KarpelesLab/lightning_debug/tools/parts.csv

# Part numbers merged into the BOM by tools/export_fab.py (key = value + footprint).
# lcsc = JLCPCB/LCSC part (all checked against the JLCPCB parts library on 2026-11-09:
# exact MPN match | in stock); manufacturer/mpn for PCBWay. Resistors/caps/ferrite/crystal
# are JLCPCB basic parts where one exists; the rest are extended parts (setup fee each).
value | footprint | lcsc | manufacturer | mpn | refs
USER | Button_Switch_SMD:SW_SPST_PTS810 | C116501 | C&K | PTS810SJM250SMTRLFS | SW1
100n | Capacitor_SMD:C_0603_1608Metric | C14663 | YAGEO | CC0603KRX7R9BB104 | C2 C10 C11 C12 C14 C15 C16 C17 C18 C19 C23 C25 C26 C28 C29 C30 C31 C32 C33 C35 C36
1u | Capacitor_SMD:C_0603_1608Metric | C15849 | Samsung | CL10A105KB8NNNC | C3 C5 C27
27p | Capacitor_SMD:C_0603_1608Metric | C1656 | Samsung | CL10C270JB8NNNC | C20 C21
10u | Capacitor_SMD:C_0805_2012Metric | C15850 | Samsung | CL21A106KAYNNNE | C1 C4 C6 C7 C22 C24 C37 C38
4.7u | Capacitor_SMD:C_0805_2012Metric | C1779 | Samsung | CL21A475KAQNNNE | C8 C9 C13 C34
USB_C_Receptacle_USB2.0_16P | Connector_USB:USB_C_Receptacle_HRO_TYPE-C-31-M-12 | C165948 | Korean Hroparts | TYPE-C-31-M-12 | J1 J2
12MHz | Crystal:Crystal_SMD_3225-4Pin_3.2x2.5mm | C9002 | Yangxing | X322512MSB4SI | Y1
1.5A hold | Fuse:Fuse_1206_3216Metric | C20802 | Sunlord | SMD1206P150TF | F1
600R@100MHz | Inductor_SMD:L_0603_1608Metric | C1002 | Sunlord | GZ1608D601TF | FB1
blue | LED_SMD:LED_0603_1608Metric | C2288 | Hubei KENTO | KT-0603B | D5
green | LED_SMD:LED_0603_1608Metric | C12624 | Hubei KENTO | KT-0603G | D4
green PWR | LED_SMD:LED_0603_1608Metric | C12624 | Hubei KENTO | KT-0603G | D1
red | LED_SMD:LED_0603_1608Metric | C2286 | Hubei KENTO | KT-0603R | D3
yellow LTG PWR | LED_SMD:LED_0603_1608Metric | C2287 | Hubei KENTO | KT-0603Y | D2
ASE-12.000MHz | Oscillator:Oscillator_SMD_Abracon_ASE-4Pin_3.2x2.5mm | C596950 | Abracon | ASE-12.000MHZ-LC-T | X1
ICE40UP5K-SG48ITR | Package_DFN_QFN:QFN-48-1EP_7x7mm_P0.5mm_EP5.6x5.6mm | C2678152 | Lattice | ICE40UP5K-SG48I | U7
FT2232HQ | Package_DFN_QFN:QFN-64-1EP_9x9mm_P0.5mm_EP4.35x4.35mm | C193662 | FTDI | FT2232HQ-REEL | U5
FSUSB42MUX | Package_SO:MSOP-10_3x3mm_P0.5mm | C11355 | onsemi | FSUSB42MUX | U10 U11
93LC56B | Package_SO:SOIC-8_3.9x4.9mm_P1.27mm | C6164 | Microchip | 93LC56BT-I/SN | U6
W25Q128JVS | Package_SO:SOIC-8_5.3x5.3mm_P1.27mm | C97521 | Winbond | W25Q128JVSIQ | U8
AP2112K-1.2 | Package_TO_SOT_SMD:SOT-23-5 | C460310 | Diodes Inc | AP2112K-1.2TRG1 | U3
AP2112K-1.8 | Package_TO_SOT_SMD:SOT-23-5 | C176944 | Diodes Inc | AP2112K-1.8TRG1 | U4
AP2112K-3.3 | Package_TO_SOT_SMD:SOT-23-5 | C51118 | Diodes Inc | AP2112K-3.3TRG1 | U2
TPS2065CDBV | Package_TO_SOT_SMD:SOT-23-5 | C353882 | Texas Instruments | TPS2065CDBVR | U12
USBLC6-2SC6 | Package_TO_SOT_SMD:SOT-23-6 | C7519 | STMicroelectronics | USBLC6-2SC6 | U1 U9
100 | Resistor_SMD:R_0603_1608Metric | C22775 | UNI-ROYAL | 0603WAF1000T5E | R10
100k | Resistor_SMD:R_0603_1608Metric | C25803 | UNI-ROYAL | 0603WAF1003T5E | R41
10k | Resistor_SMD:R_0603_1608Metric | C25804 | UNI-ROYAL | 0603WAF1002T5E | R5 R6 R7 R8 R11 R12 R13 R14 R15 R29 R30 R31 R32 R35 R37 R38 R39 R40 R42 R44
12k 1% | Resistor_SMD:R_0603_1608Metric | C22790 | UNI-ROYAL | 0603WAF1202T5E | R4
1k | Resistor_SMD:R_0603_1608Metric | C21190 | UNI-ROYAL | 0603WAF1001T5E | R3
2.2k | Resistor_SMD:R_0603_1608Metric | C4190 | UNI-ROYAL | 0603WAF2201T5E | R9 R43
33 | Resistor_SMD:R_0603_1608Metric | C23140 | UNI-ROYAL | 0603WAF330JT5E | R16 R17 R18 R19 R20 R21 R22 R23 R24 R25 R26 R27 R28
4.7k | Resistor_SMD:R_0603_1608Metric | C23162 | UNI-ROYAL | 0603WAF4701T5E | R36
5.1k | Resistor_SMD:R_0603_1608Metric | C23186 | UNI-ROYAL | 0603WAF5101T5E | R1 R2 R33 R34
