KarpelesLab/lightning_debug/docs/APPLE-LM-BO-V1AV Drawing Rev1.0.pdf

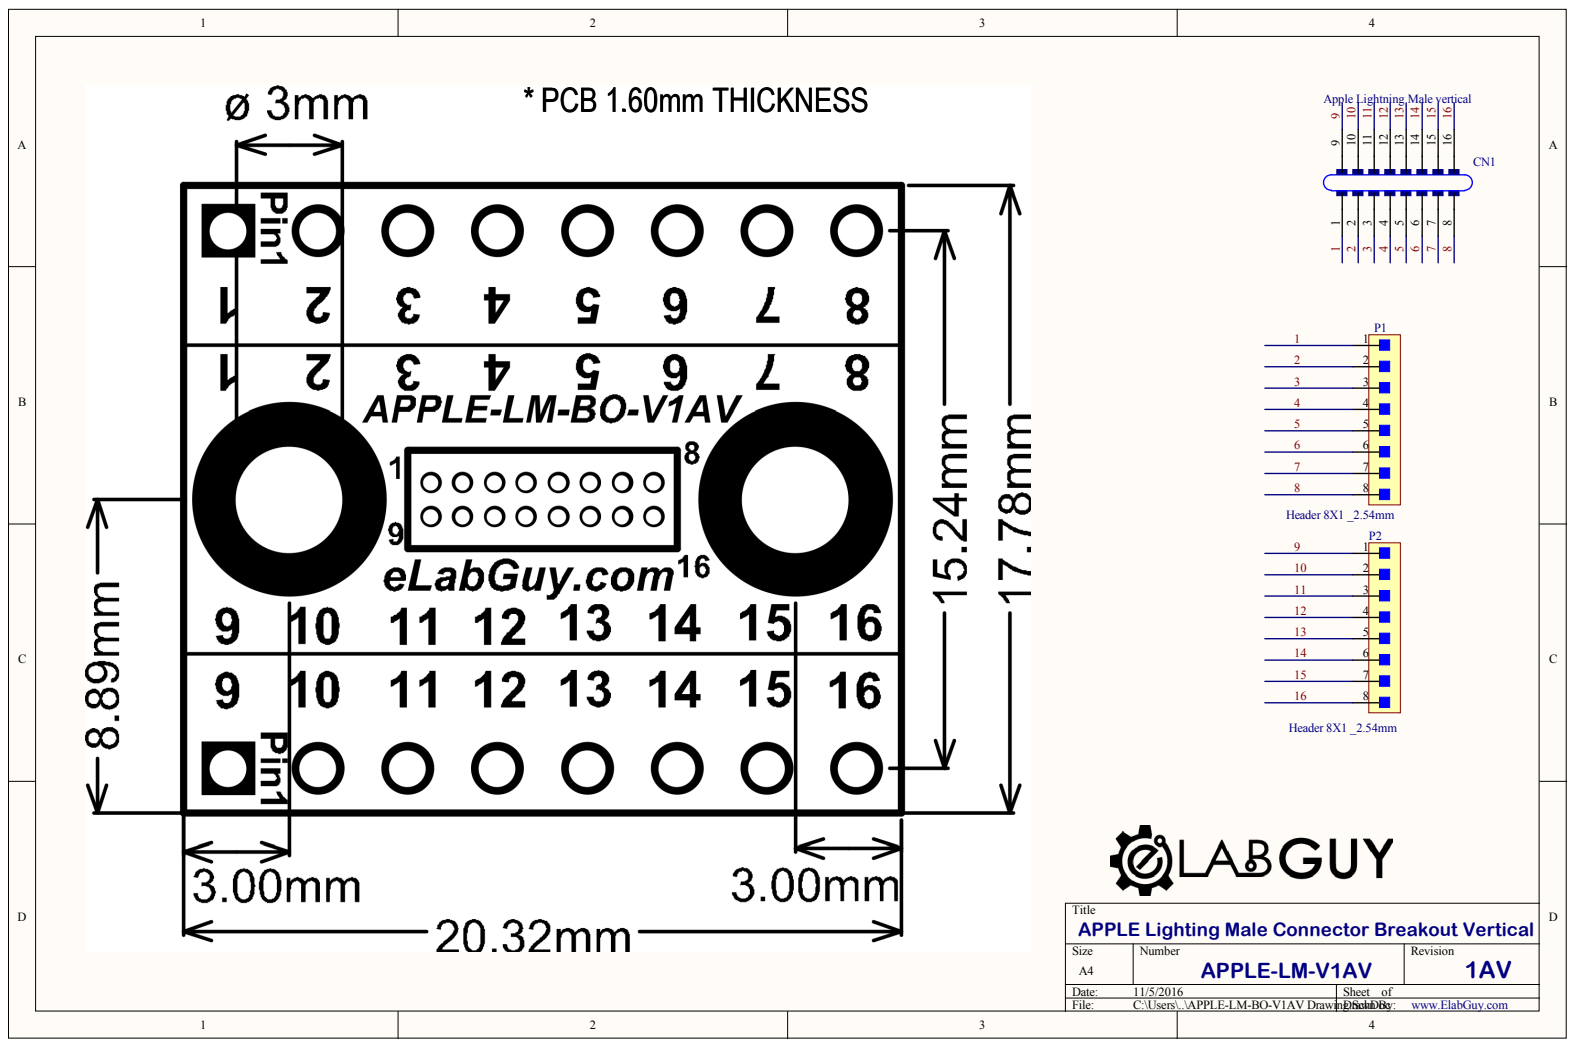
[picture p4: page 1]

Apple Lightning Male vertical

Title
APPLE Lighting Male Connector Breakout Vertical

Size A4 | Number APPLE-LM-V1AV | Revision 1AV

Date: 11/5/2016 | Sheet of
File: C:\Users\..\APPLE-LM-BO-V1AV Drawing. DrSacwhDn Bocy: | www.ElabGuy.com
