KarpelesLab/lightning_debug/docs/APPLE-LM-BO-V2A Drawing Rev1.0.pdf

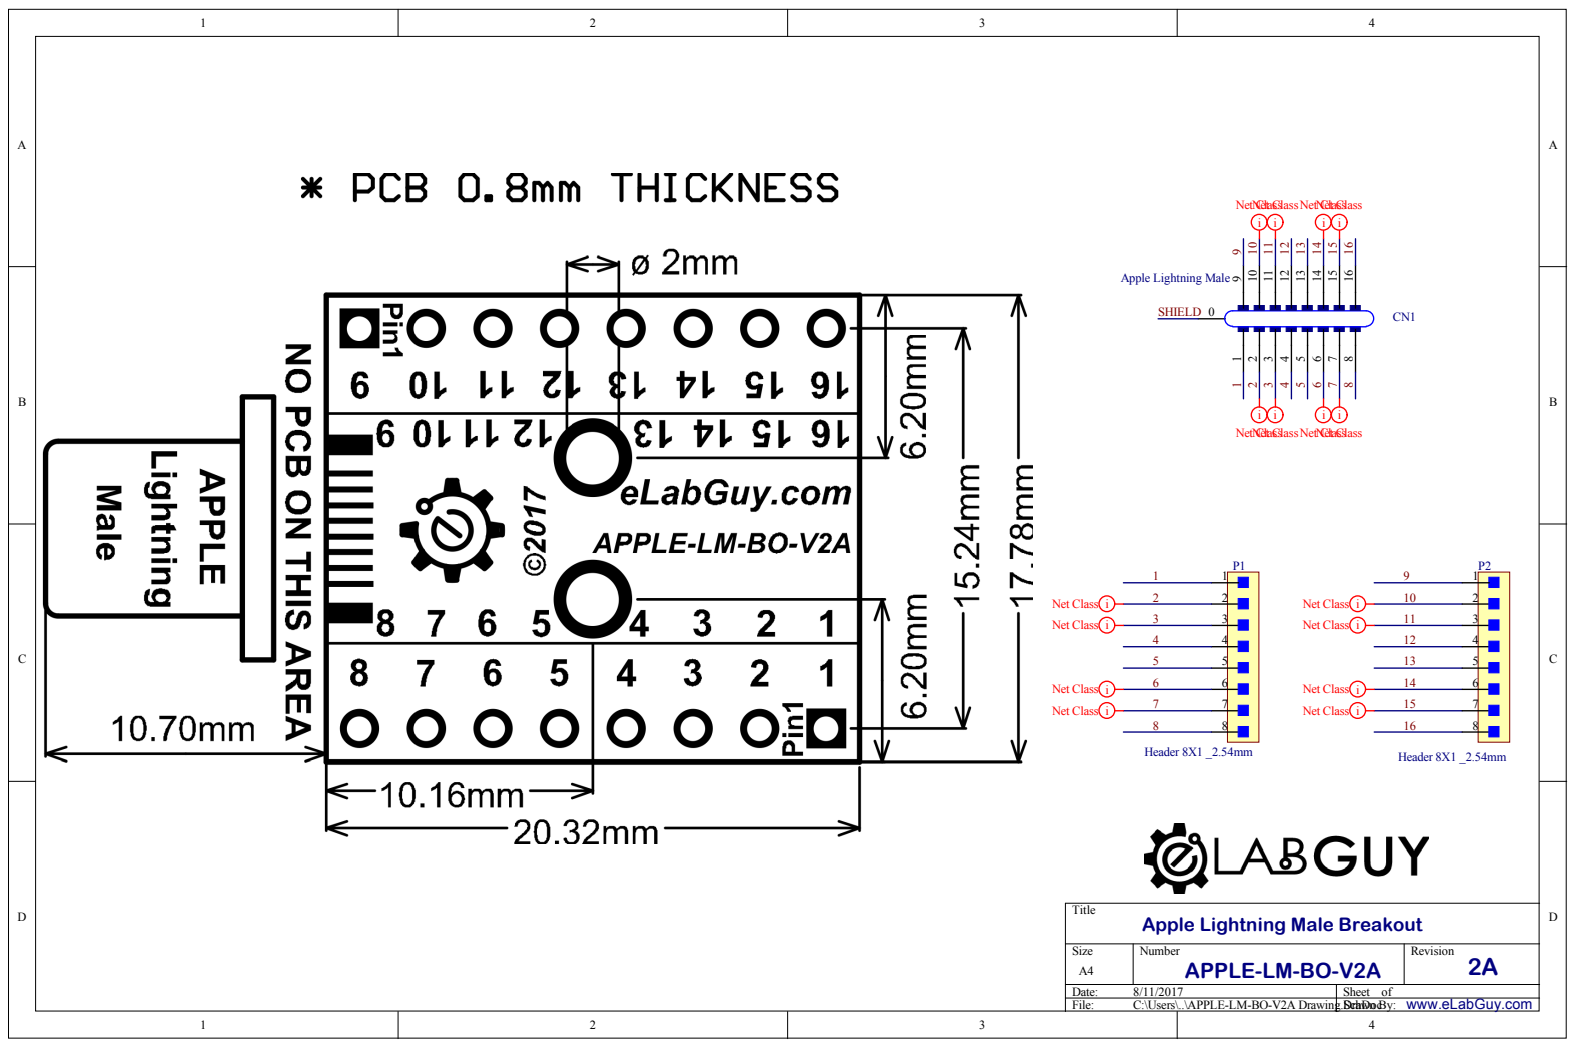
[picture p5: page 1]

Apple Lightning Male Breakout

Size A4 | Number APPLE-LM-BO-V2A | Revision 2A

Date: 8/11/2017 | Sheet of
File: C:\Users\..\APPLE-LM-BO-V2A Drawing.DScrhDawn ocBy: | www.eLabGuy.com
