KarpelesLab/lightning_debug/lightning_debug.kicad_pcb

## KiCad design lightning_debug.kicad_pcb (2026-11-09)

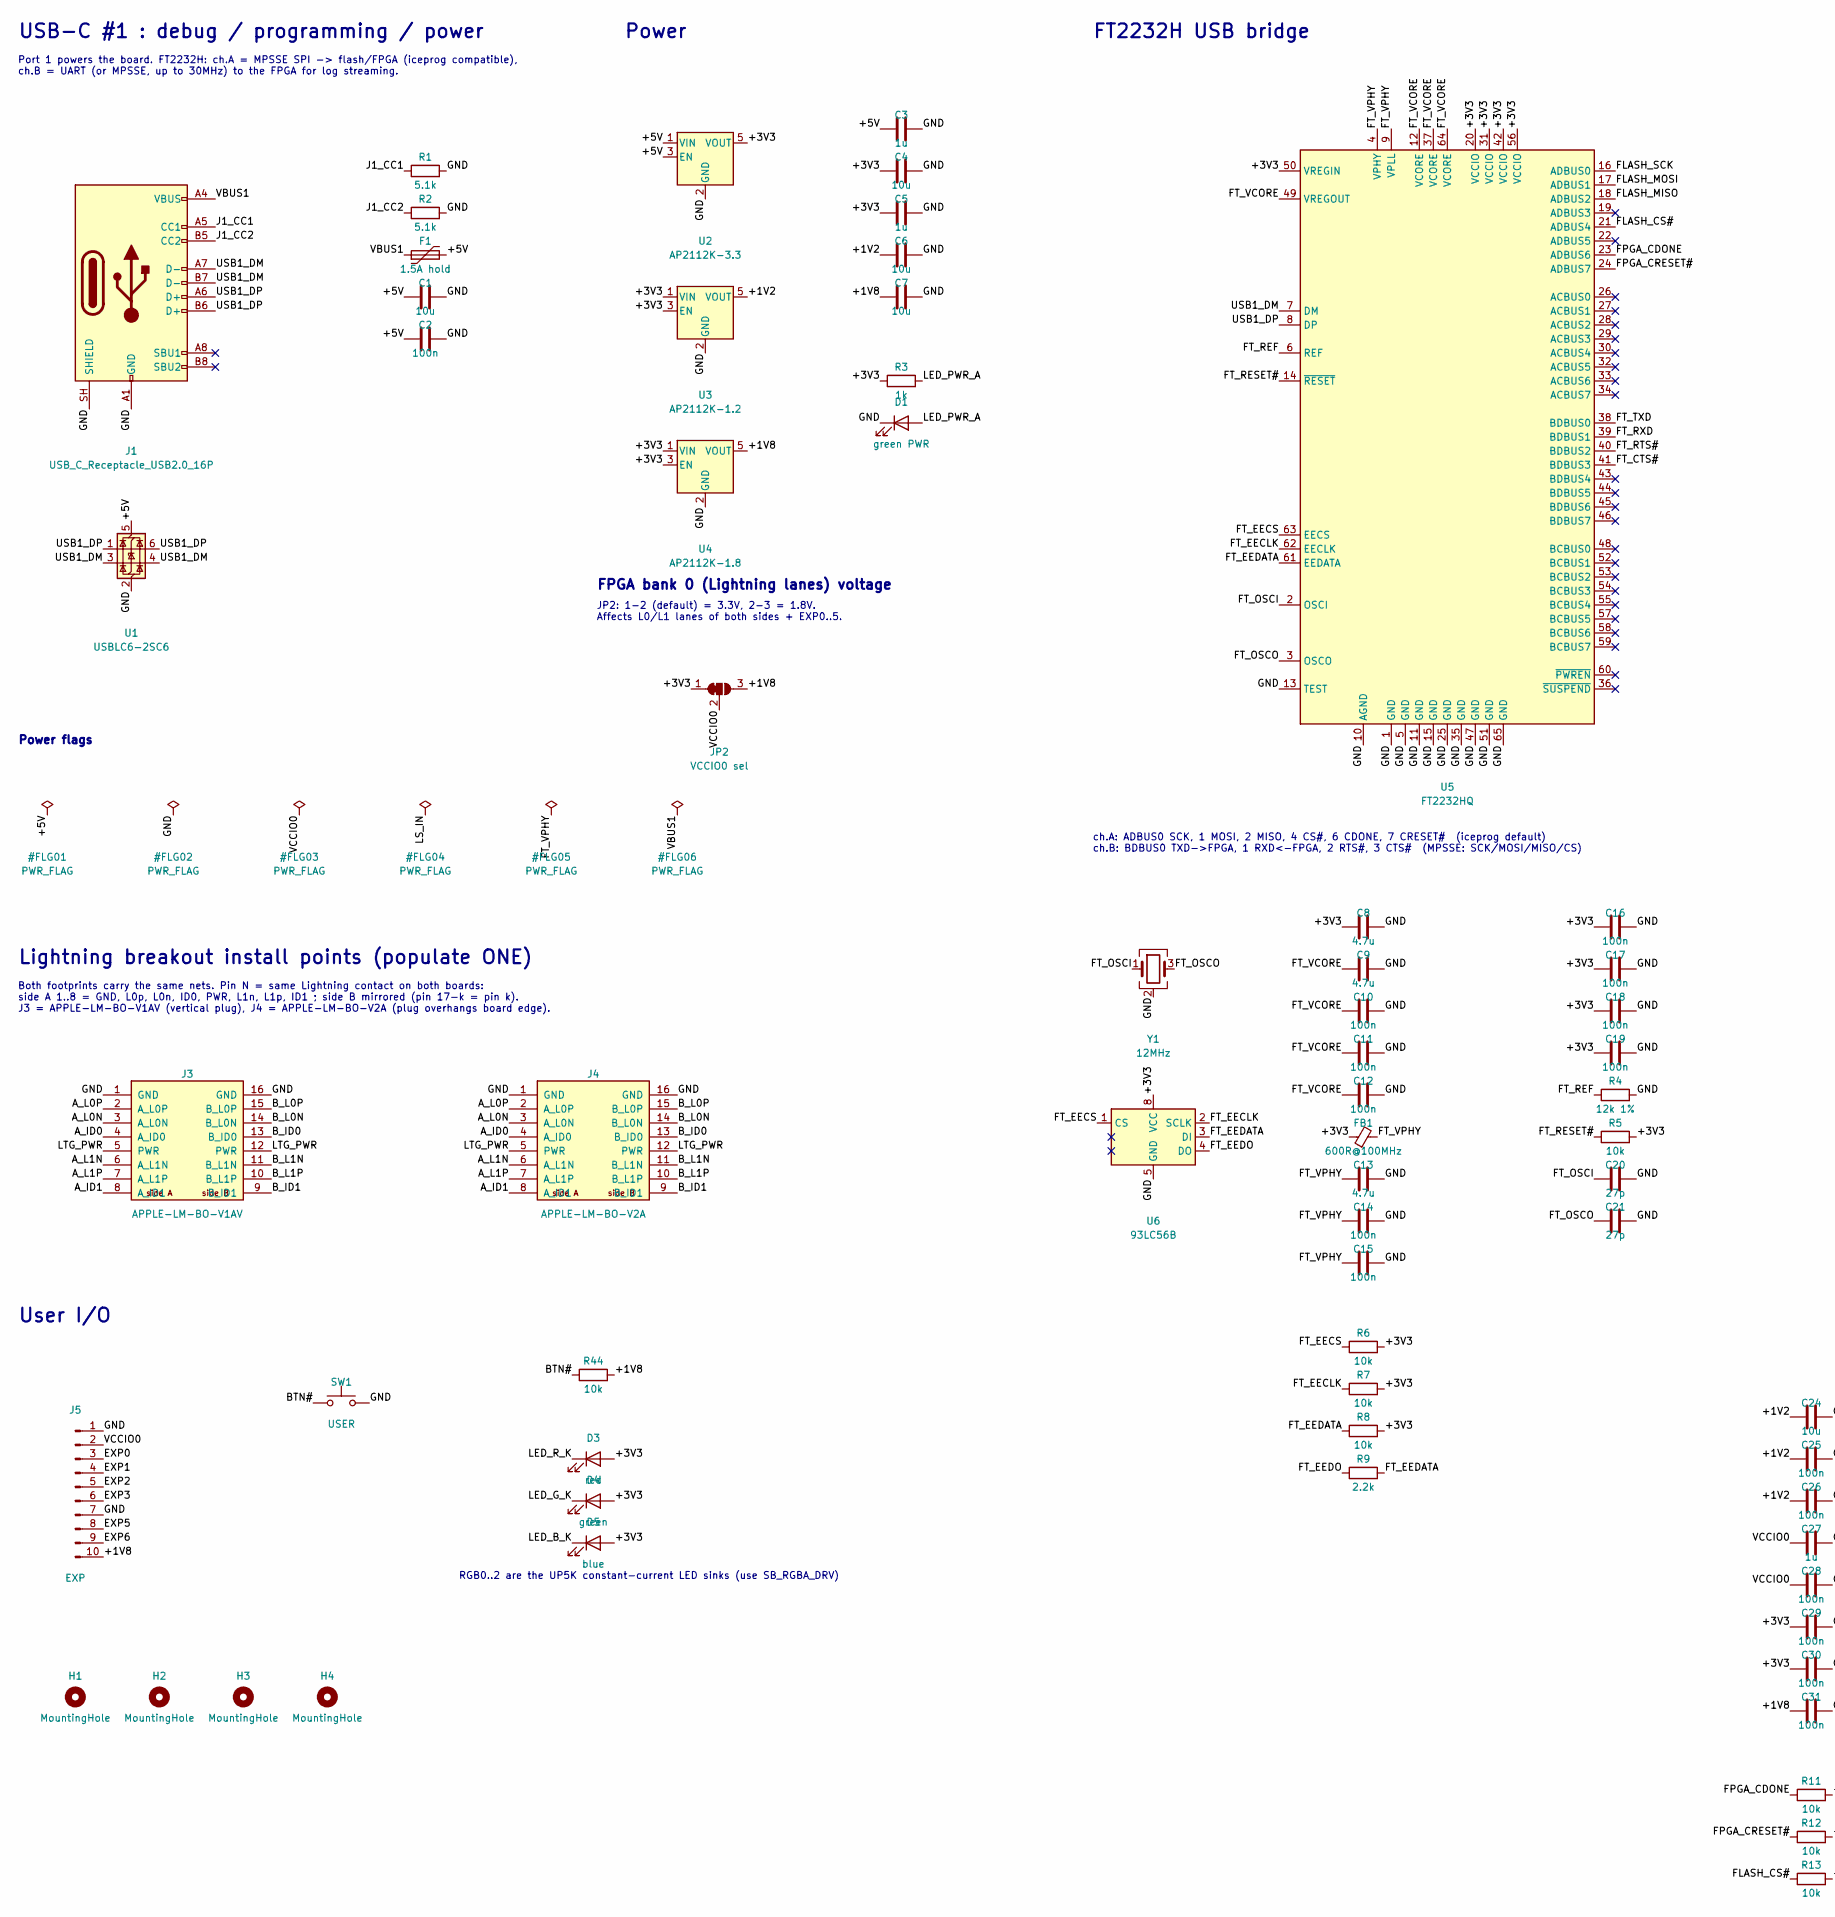
[picture p6: schematic lightning_debug.kicad_sch, Lightning debug board, part in row 1, column 1]

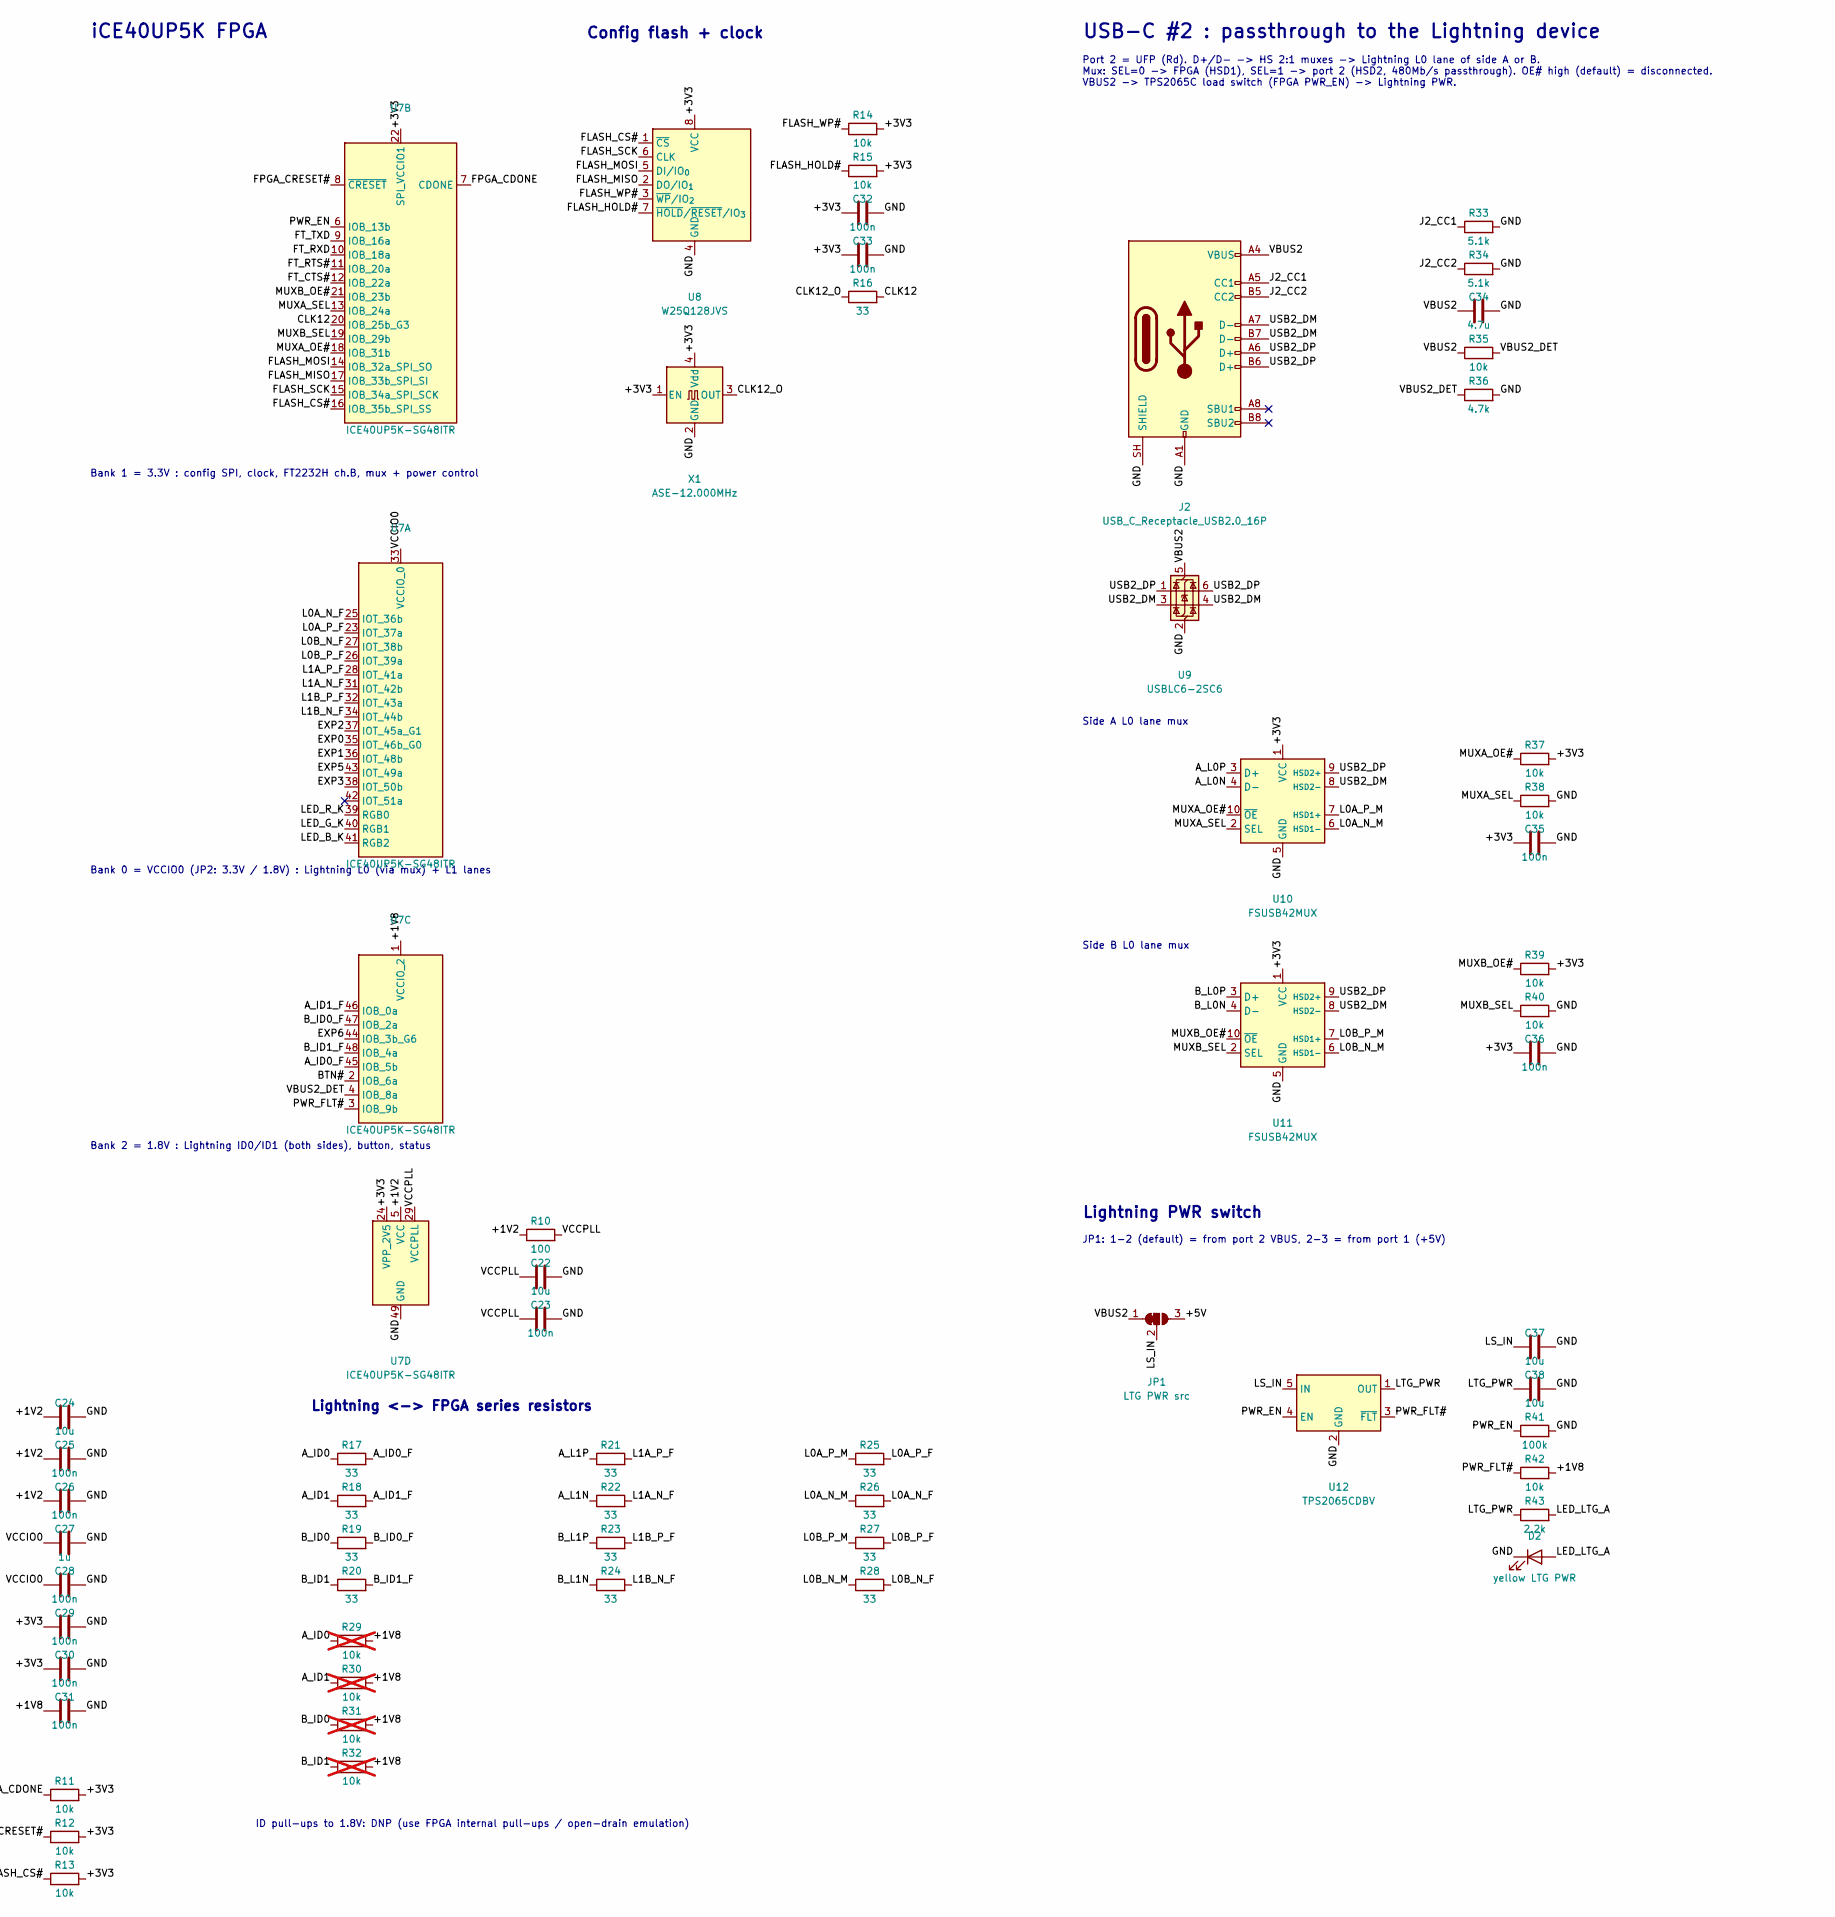
[picture p7: schematic lightning_debug.kicad_sch, Lightning debug board, part in row 1, column 2]

Parts:
C1, C4, C6, C7, C22, C24, C37, C38: 10u; C_0805_2012Metric
C2, C10, C11, C12, C14, C15, C16, C17, C18, C19, C23, C25, C26, C28, C29, C30, C31, C32, C33, C35, C36: 100n; C_0603_1608Metric
C3, C5, C27: 1u; C_0603_1608Metric
C8, C9, C13, C34: 4.7u; C_0805_2012Metric
C20, C21: 27p; C_0603_1608Metric
D1: green PWR; LED_0603_1608Metric
D2: yellow LTG PWR; LED_0603_1608Metric
D3: red; LED_0603_1608Metric
D4: green; LED_0603_1608Metric
D5: blue; LED_0603_1608Metric
F1: 1.5A hold; Fuse_1206_3216Metric
FB1: 600R@100MHz; L_0603_1608Metric
H1, H2, H3, H4: MountingHole; MountingHole_3.2mm_M3
J1, J2: USB_C_Receptacle_USB2.0_16P; USB_C_Receptacle_HRO_TYPE-C-31-M-12
J3: APPLE-LM-BO-V1AV; eLabGuy_APPLE-LM-BO-V1AV
J4: APPLE-LM-BO-V2A; eLabGuy_APPLE-LM-BO-V2A
J5: EXP; PinHeader_1x10_P2.54mm_Vertical
JP1: LTG PWR src; SolderJumper-3_P1.3mm_Bridged12_RoundedPad1.0x1.5mm
JP2: VCCIO0 sel; SolderJumper-3_P1.3mm_Bridged12_RoundedPad1.0x1.5mm
R1, R2, R33, R34: 5.1k; R_0603_1608Metric
R3: 1k; R_0603_1608Metric
R4: 12k 1%; R_0603_1608Metric
R5, R6, R7, R8, R11, R12, R13, R14, R15, R35, R37, R38, R39, R40, R42, R44: 10k; R_0603_1608Metric
R9, R43: 2.2k; R_0603_1608Metric
R10: 100; R_0603_1608Metric
R16, R17, R18, R19, R20, R21, R22, R23, R24, R25, R26, R27, R28: 33; R_0603_1608Metric
R29, R30, R31, R32: 10k; R_0603_1608Metric; not fitted
R36: 4.7k; R_0603_1608Metric
R41: 100k; R_0603_1608Metric
SW1: USER; SW_SPST_PTS810
U1, U9: USBLC6-2SC6; SOT-23-6
U2: AP2112K-3.3; SOT-23-5
U3: AP2112K-1.2; SOT-23-5
U4: AP2112K-1.8; SOT-23-5
U5: FT2232HQ; QFN-64-1EP_9x9mm_P0.5mm_EP4.35x4.35mm
U6: 93LC56B; SOIC-8_3.9x4.9mm_P1.27mm
U7: ICE40UP5K-SG48ITR; QFN-48-1EP_7x7mm_P0.5mm_EP5.6x5.6mm
U8: W25Q128JVS; SOIC-8_5.3x5.3mm_P1.27mm
U10, U11: FSUSB42MUX; MSOP-10_3x3mm_P0.5mm
U12: TPS2065CDBV; SOT-23-5
X1: ASE-12.000MHz; Oscillator_SMD_Abracon_ASE-4Pin_3.2x2.5mm
Y1: 12MHz; Crystal_SMD_3225-4Pin_3.2x2.5mm

Connections:
/+1V2: C6.1, C24.1, C25.1, C26.1, R10.1, U3.5 (VOUT), U7.5 (VCC), U7.30 (VCC)
/+1V8: C7.1, C31.1, J5.10, JP2.3 (B), R29.2, R30.2, R31.2, R32.2, R42.2, R44.2, U4.5 (VOUT), U7.1 (VCCIO_2)
/+3V3: C4.1, C5.1, C8.1, C16.1, C17.1, C18.1, C19.1, C29.1, C30.1, C32.1, C33.1, C35.1, C36.1, D3.2 (A), D4.2 (A), D5.2 (A), FB1.1, JP2.1 (A), R3.1, R5.2, R6.2, R7.2, R8.2, R11.2, R12.2, R13.2, R14.2, R15.2, R37.2, R39.2, U2.5 (VOUT), U3.1 (VIN), U3.3 (EN), U4.1 (VIN), U4.3 (EN), U5.20 (VCCIO), U5.31 (VCCIO), U5.42 (VCCIO), U5.50 (VREGIN), U5.56 (VCCIO), U6.8 (VCC), U7.22 (SPI_VCCIO1), U7.24 (VPP_2V5), U8.8 (VCC), U10.1 (VCC), U11.1 (VCC), X1.1 (EN), X1.4 (Vdd)
/+5V: C1.1, C2.1, C3.1, F1.2, JP1.3 (B), U1.5 (VBUS), U2.1 (VIN), U2.3 (EN)
/A_ID0: J3.4 (A_ID0), J4.4 (A_ID0), R17.1, R29.1
/A_ID0_F: R17.2, U7.45 (IOB_5b)
/A_ID1: J3.8 (A_ID1), J4.8 (A_ID1), R18.1, R30.1
/A_ID1_F: R18.2, U7.46 (IOB_0a)
/A_L0N: J3.3 (A_L0N), J4.3 (A_L0N), U10.4 (D-)
/A_L0P: J3.2 (A_L0P), J4.2 (A_L0P), U10.3 (D+)
/A_L1N: J3.6 (A_L1N), J4.6 (A_L1N), R22.1
/A_L1P: J3.7 (A_L1P), J4.7 (A_L1P), R21.1
/BTN#: R44.1, SW1.1, U7.2 (IOB_6a)
/B_ID0: J3.13 (B_ID0), J4.13 (B_ID0), R19.1, R31.1
/B_ID0_F: R19.2, U7.47 (IOB_2a)
/B_ID1: J3.9 (B_ID1), J4.9 (B_ID1), R20.1, R32.1
/B_ID1_F: R20.2, U7.48 (IOB_4a)
/B_L0N: J3.14 (B_L0N), J4.14 (B_L0N), U11.4 (D-)
/B_L0P: J3.15 (B_L0P), J4.15 (B_L0P), U11.3 (D+)
/B_L1N: J3.11 (B_L1N), J4.11 (B_L1N), R24.1
/B_L1P: J3.10 (B_L1P), J4.10 (B_L1P), R23.1
/CLK12: R16.2, U7.20 (IOB_25b_G3)
/CLK12_O: R16.1, X1.3 (OUT)
/EXP0: J5.3, U7.35 (IOT_46b_G0)
/EXP1: J5.4, U7.36 (IOT_48b)
/EXP2: J5.5, U7.37 (IOT_45a_G1)
/EXP3: J5.6, U7.38 (IOT_50b)
/EXP5: J5.8, U7.43 (IOT_49a)
/EXP6: J5.9, U7.44 (IOB_3b_G6)
/FLASH_CS#: R13.1, U5.21 (ADBUS4), U7.16 (IOB_35b_SPI_SS), U8.1 (~CS)
/FLASH_HOLD#: R15.1, U8.7 (~HOLD/~RESET/IO_{3})
/FLASH_MISO: U5.18 (ADBUS2), U7.17 (IOB_33b_SPI_SI), U8.2 (DO/IO_{1})
/FLASH_MOSI: U5.17 (ADBUS1), U7.14 (IOB_32a_SPI_SO), U8.5 (DI/IO_{0})
/FLASH_SCK: U5.16 (ADBUS0), U7.15 (IOB_34a_SPI_SCK), U8.6 (CLK)
/FLASH_WP#: R14.1, U8.3 (~WP/IO_{2})
/FPGA_CDONE: R11.1, U5.23 (ADBUS6), U7.7 (CDONE)
/FPGA_CRESET#: R12.1, U5.24 (ADBUS7), U7.8 (~CRESET)
/FT_CTS#: U5.41 (BDBUS3), U7.12 (IOB_22a)
/FT_EECLK: R7.1, U5.62 (EECLK), U6.2 (SCLK)
/FT_EECS: R6.1, U5.63 (EECS), U6.1 (CS)
/FT_EEDATA: R8.1, R9.2, U5.61 (EEDATA), U6.3 (DI)
/FT_EEDO: R9.1, U6.4 (DO)
/FT_OSCI: C20.1, U5.2 (OSCI), Y1.1
/FT_OSCO: C21.1, U5.3 (OSCO), Y1.3
/FT_REF: R4.1, U5.6 (REF)
/FT_RESET#: R5.1, U5.14 (~RESET)
/FT_RTS#: U5.40 (BDBUS2), U7.11 (IOB_20a)
/FT_RXD: U5.39 (BDBUS1), U7.10 (IOB_18a)
/FT_TXD: U5.38 (BDBUS0), U7.9 (IOB_16a)
/FT_VCORE: C9.1, C10.1, C11.1, C12.1, U5.12 (VCORE), U5.37 (VCORE), U5.49 (VREGOUT), U5.64 (VCORE)
/FT_VPHY: C13.1, C14.1, C15.1, FB1.2, U5.4 (VPHY), U5.9 (VPLL)
/GND: C1.2, C2.2, C3.2, C4.2, C5.2, C6.2, C7.2, C8.2, C9.2, C10.2, C11.2, C12.2, C13.2, C14.2, C15.2, C16.2, C17.2, C18.2, C19.2, C20.2, C21.2, C22.2, C23.2, C24.2, C25.2, C26.2, C27.2, C28.2, C29.2, C30.2, C31.2, C32.2, C33.2, C34.2, C35.2, C36.2, C37.2, C38.2, D1.1 (K), D2.1 (K), J1.A1 (GND), J1.A12 (GND), J1.B1 (GND), J1.B12 (GND), J1.SH (SHIELD), J2.A1 (GND), J2.A12 (GND), J2.B1 (GND), J2.B12 (GND), J2.SH (SHIELD), J3.1 (GND), J3.16 (GND), J4.1 (GND), J4.16 (GND), J5.1, J5.7, R1.2, R2.2, R4.2, R33.2, R34.2, R36.2, R38.2, R40.2, R41.2, SW1.2, U1.2 (GND), U2.2 (GND), U3.2 (GND), U4.2 (GND), U5.1 (GND), U5.5 (GND), U5.10 (AGND), U5.11 (GND), U5.13 (TEST), U5.15 (GND), U5.25 (GND), U5.35 (GND), U5.47 (GND), U5.51 (GND), U5.65 (GND), U6.5 (GND), U7.49 (GND), U8.4 (GND), U9.2 (GND), U10.5 (GND), U11.5 (GND), U12.2 (GND), X1.2 (GND), Y1.2 (G), Y1.4 (G)
/J1_CC1: J1.A5 (CC1), R1.1
/J1_CC2: J1.B5 (CC2), R2.1
/J2_CC1: J2.A5 (CC1), R33.1
/J2_CC2: J2.B5 (CC2), R34.1
/L0A_N_F: R26.2, U7.25 (IOT_36b)
/L0A_N_M: R26.1, U10.6 (HSD1-)
/L0A_P_F: R25.2, U7.23 (IOT_37a)
/L0A_P_M: R25.1, U10.7 (HSD1+)
/L0B_N_F: R28.2, U7.27 (IOT_38b)
/L0B_N_M: R28.1, U11.6 (HSD1-)
/L0B_P_F: R27.2, U7.26 (IOT_39a)
/L0B_P_M: R27.1, U11.7 (HSD1+)
/L1A_N_F: R22.2, U7.31 (IOT_42b)
/L1A_P_F: R21.2, U7.28 (IOT_41a)
/L1B_N_F: R24.2, U7.34 (IOT_44b)
/L1B_P_F: R23.2, U7.32 (IOT_43a)
/LED_B_K: D5.1 (K), U7.41 (RGB2)
/LED_G_K: D4.1 (K), U7.40 (RGB1)
/LED_LTG_A: D2.2 (A), R43.2
/LED_PWR_A: D1.2 (A), R3.2
/LED_R_K: D3.1 (K), U7.39 (RGB0)
/LS_IN: C37.1, JP1.2 (C), U12.5 (IN)
/LTG_PWR: C38.1, J3.5 (PWR), J3.12 (PWR), J4.5 (PWR), J4.12 (PWR), R43.1, U12.1 (OUT)
/MUXA_OE#: R37.1, U7.18 (IOB_31b), U10.10 (~OE)
/MUXA_SEL: R38.1, U7.13 (IOB_24a), U10.2 (SEL)
/MUXB_OE#: R39.1, U7.21 (IOB_23b), U11.10 (~OE)
/MUXB_SEL: R40.1, U7.19 (IOB_29b), U11.2 (SEL)
/PWR_EN: R41.1, U7.6 (IOB_13b), U12.4 (EN)
/PWR_FLT#: R42.1, U7.3 (IOB_9b), U12.3 (~FLT)
/USB1_DM: J1.A7 (D-), J1.B7 (D-), U1.3 (I/O2), U1.4 (I/O2), U5.7 (DM)
/USB1_DP: J1.A6 (D+), J1.B6 (D+), U1.1 (I/O1), U1.6 (I/O1), U5.8 (DP)
/USB2_DM: J2.A7 (D-), J2.B7 (D-), U9.3 (I/O2), U9.4 (I/O2), U10.8 (HSD2-), U11.8 (HSD2-)
/USB2_DP: J2.A6 (D+), J2.B6 (D+), U9.1 (I/O1), U9.6 (I/O1), U10.9 (HSD2+), U11.9 (HSD2+)
/VBUS1: F1.1, J1.A4 (VBUS), J1.A9 (VBUS), J1.B4 (VBUS), J1.B9 (VBUS)
/VBUS2: C34.1, J2.A4 (VBUS), J2.A9 (VBUS), J2.B4 (VBUS), J2.B9 (VBUS), JP1.1 (A), R35.1, U9.5 (VBUS)
/VBUS2_DET: R35.2, R36.1, U7.4 (IOB_8a)
/VCCIO0: C27.1, C28.1, J5.2, JP2.2 (C), U7.33 (VCCIO_0)
/VCCPLL: C22.1, C23.1, R10.2, U7.29 (VCCPLL)

Notes on the sheet:
User I/O
ch.A: ADBUS0 SCK, 1 MOSI, 2 MISO, 4 CS#, 6 CDONE, 7 CRESET# (iceprog default) ch.B: BDBUS0 TXD->FPGA, 1 RXD<-FPGA, 2 RTS#, 3 CTS# (MPSSE: SCK/MOSI/MISO/CS)
Power flags
Lightning PWR switch
RGB0..2 are the UP5K constant-current LED sinks (use SB_RGBA_DRV)
JP2: 1-2 (default) = 3.3V, 2-3 = 1.8V. Affects L0/L1 lanes of both sides + EXP0..5.
FT2232H USB bridge
Port 2 = UFP (Rd). D+/D- -> HS 2:1 muxes -> Lightning L0 lane of side A or B. Mux: SEL=0 -> FPGA (HSD1), SEL=1 -> port 2 (HSD2, 480Mb/s passthrough). OE# high (default) = disconnected. VBUS2 -> TPS2065C load switch (FPGA PWR_EN) -> Lightning PWR.
Lightning <-> FPGA series resistors
iCE40UP5K FPGA
Bank 0 = VCCIO0 (JP2: 3.3V / 1.8V) : Lightning L0 (via mux) + L1 lanes
USB-C #2 : passthrough to the Lightning device
Port 1 powers the board. FT2232H: ch.A = MPSSE SPI -> flash/FPGA (iceprog compatible), ch.B = UART (or MPSSE, up to 30MHz) to the FPGA for log streaming.
Both footprints carry the same nets. Pin N = same Lightning contact on both boards: side A 1..8 = GND, L0p, L0n, ID0, PWR, L1n, L1p, ID1 ; side B mirrored (pin 17-k = pin k). J3 = APPLE-LM-BO-V1AV (vertical plug), J4 = APPLE-LM-BO-V2A (plug overhangs board edge).
FPGA bank 0 (Lightning lanes) voltage
USB-C #1 : debug / programming / power
Bank 2 = 1.8V : Lightning ID0/ID1 (both sides), button, status
Side B L0 lane mux
Lightning breakout install points (populate ONE)
Power
Config flash + clock
Bank 1 = 3.3V : config SPI, clock, FT2232H ch.B, mux + power control
Side A L0 lane mux
ID pull-ups to 1.8V: DNP (use FPGA internal pull-ups / open-drain emulation)
JP1: 1-2 (default) = from port 2 VBUS, 2-3 = from port 1 (+5V)

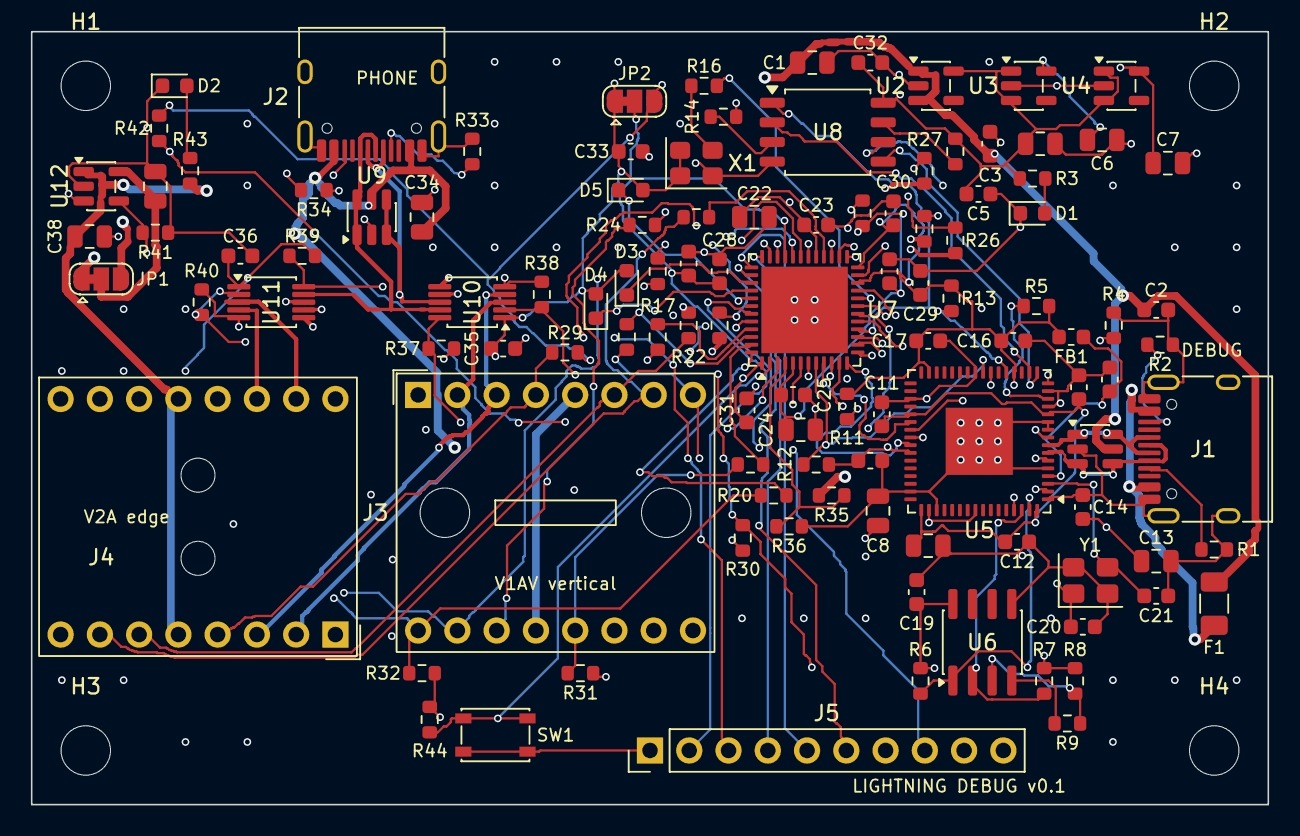
[picture p8: board lightning_debug.kicad_pcb from above]

Board: 4 copper layers, 80.0 x 50.0 mm, 115 parts (0 on the bottom side), 90 nets.
