KarpelesLab/lightning_debug/(commit log)

2026-11-08 Lightning debug board: KiCad project, generators, gateware pins, fab export
    iCE40UP5K + FT2232H carrier for eLabGuy Lightning breakouts (V1AV / V2A
    install points), FSUSB42 USB passthrough muxes, TPS2065C phone power switch.
    Board placed and autorouted (WIP: a few connections left).
    [lightning_debug.kicad_pcb, lightning_debug.kicad_sch, parts.csv]
2026-11-08 autoroute: headless Freerouting 2.5 (Java 25), widen necked tracks, drop degenerate wires
    - autoroute.py runs Freerouting headless only (--gui.enabled=false, no DISPLAY,
    java.awt.headless) and picks a Java 25 runtime for 2.5+ jars
    - SES import in a child process (second LoadBoard in one process breaks)
    - gen_pcb.py: PCB_OUT / PCB_MARGIN / PCB_U7 knobs for placement experiments
    - README: VCCPLL filter and RGB LED supply checked against the datasheet
2026-11-08 finish_route.py: rip-up + grid A* to close what the autorouter leaves open
    Removes DRC-flagged items (dangling, edge/clearance violators) and In1 tracks
    (keeps the GND reference plane solid), re-routes open connections on
    F.Cu/B.Cu/In2 (In1 only as a last resort, 1 mm away from the USB nets),
    fixes via annular rings and adds GND stitching vias.
2026-11-08 Route the board: DRC clean, release fab files, current renders, README rewrite
    - PCB fully routed (headless Freerouting 2.5 + finish_route.py), 0 DRC errors,
    0 unconnected, schematic parity OK; FPGA rotated 90 deg, GND stitching
    - clearance 0.127 mm (5 mil), still inside JLCPCB/PCBWay standard 4-layer
    - EXP4 dropped (FPGA pin 42 could not be routed out): J5 pin 7 is GND now
    - fab/release: Gerbers/drill zip, JLCPCB BOM+CPL, PCBWay BOM+centroid
    - renders: top, bottom, isometric of the routed board
    - README explains the project, board status and what to review before ordering
    [bom.csv, centroid.csv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]
2026-11-09 Self-test gateware, datasheet netlist check, rescue pour islands
    - gateware/selftest.v + Makefile: uses every .pcf pin (RGB cycle, UART
    console with status/power/mux control, EXP counter); builds clean with
    yosys/nextpnr (233 LCs, 47 MHz vs 12 MHz)
    - tools/pour_islands.py: In2 GND fill under the +3V3 pour and GND vias into
    isolated B.Cu/In2 islands so more of the In2/B.Cu routing has an
    adjacent plane; board refilled, DRC clean, fab files and renders updated
    - README: verification results, honest SI status of the USB passthrough
    [lightning_debug-B_Cu.gbl, lightning_debug-B_Mask.gbs, lightning_debug-B_Paste.gbp, lightning_debug-B_Silkscreen.gbo, lightning_debug-Edge_Cuts.gm1, lightning_debug-F_Cu.gtl, lightning_debug-F_Mask.gts, lightning_debug-F_Paste.gtp]
2026-11-09 Fill LCSC / MPN for every BOM line
    All 35 lines verified against the JLCPCB parts library (exact MPN, in
    stock). Basic parts used where available; FPGA is the in-stock tray
    variant ICE40UP5K-SG48I; status LEDs are KENTO KT-0603. fab/release
    regenerated: 0 BOM lines without an LCSC number.
    [bom.csv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]
